zabalzalucas04-cell/Formula-Steering-Wheel-basen-on-Raspi-PI-PICO-W/README.md

# Formula-Steering-Wheel-basen-on-Raspi-PI-PICO-W
Procedimiento y descripcion paso a paso para crear un Aro estilo fórmula, impreso en 3D, con 4 levas digitales, 8 botones, 3 encoders rotativos, 2 swtiches de encoders y un encoder con funcion multinivel de 5 switches virtuales de seleccion de estado ciclico.

Su primera concepción se utiliza con la base PXN V10. Direct Drive Force Feedback.
WhatsApp Image 2026-11-07 at 8 04 27 PM
WhatsApp Image 2026-11-07 at 8 02 23 PM
Para ver todas las funcionalidades del aro, lée el documento "Documentación del Firmware SimRacing (Raspberry Pi Pico W)"
# Planes de mejoras a futuro:
**Mejoras de Grip:**
  * Implementación de un material elastómero para mejorar el grip y sujeción

**Cambio en el Hardware**
  * Utilización de placas controladoras con mayor compatibilidad de uso.
  * Implementación de display, dashboards, timers.

**Compatibilidad**
  * Creación de Quick Release genéricos para la compatibilidad con más bases.
  * Posibilidad de software para personalizar aro.
