zabalzalucas04-cell/Formula-Steering-Wheel-basen-on-Raspi-PI-PICO-W/Comercial Parts.md

# 📋 Lista de Componentes y Hardware del Proyecto

## ⚡ Componentes Electrónicos y Mecánicos
* **1×** Raspberry Pi Pico W
* **4×** Botones NA 12 mm
* **3×** Botones NA 7 mm
* **3×** Encoders KY-040
* Cable 0.5 mm
* **4×** Switches finales de carrera
* **8×** Imanes de neodimio (8 mm × 2 mm)

---

## 🛠️ Tornillería y Fijación
* **8×** Tornillos Phillips M3 × 16 mm *(Fijación de Grips derecho e izquierdo)*
* **9×** Tornillos rosca plástica M3 × 16 mm *(Fijación de adaptador de Quick Release y Cover)*
* **10×** Tornillos Phillips M3 × 10 mm
* **4×** Tornillos M5 × 50 mm + Tuercas correspondientes
