zabalzalucas04-cell/Formula-Steering-Wheel-basen-on-Raspi-PI-PICO-W/3D_parts/main_case_v1.stl

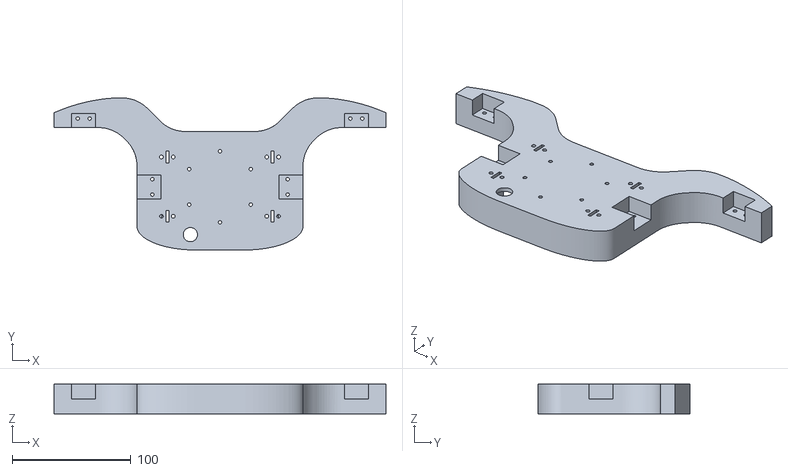
[picture p1: CAD file, 2026-11-08]
3D_parts/main_case_v1.stl
280.0 x 128.3 x 25.0
