zabalzalucas04-cell/Formula-Steering-Wheel-basen-on-Raspi-PI-PICO-W/3D_parts/Grip_R_bigstl.stl

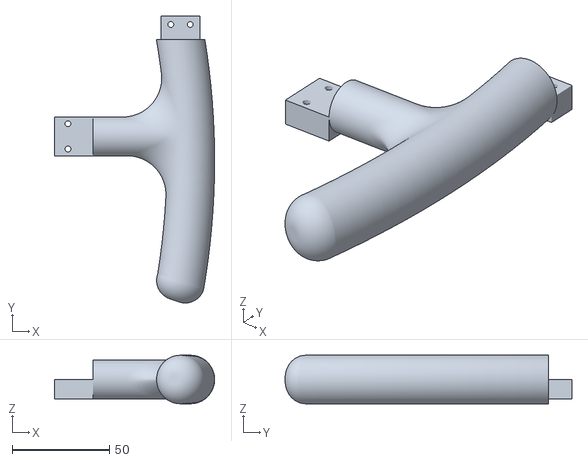
[picture p2: CAD file, 2026-11-08]
3D_parts/Grip_R_bigstl.stl
82.5 x 147.8 x 25.0
