zabalzalucas04-cell/Formula-Steering-Wheel-basen-on-Raspi-PI-PICO-W/3D_parts/Shifter_body.stl

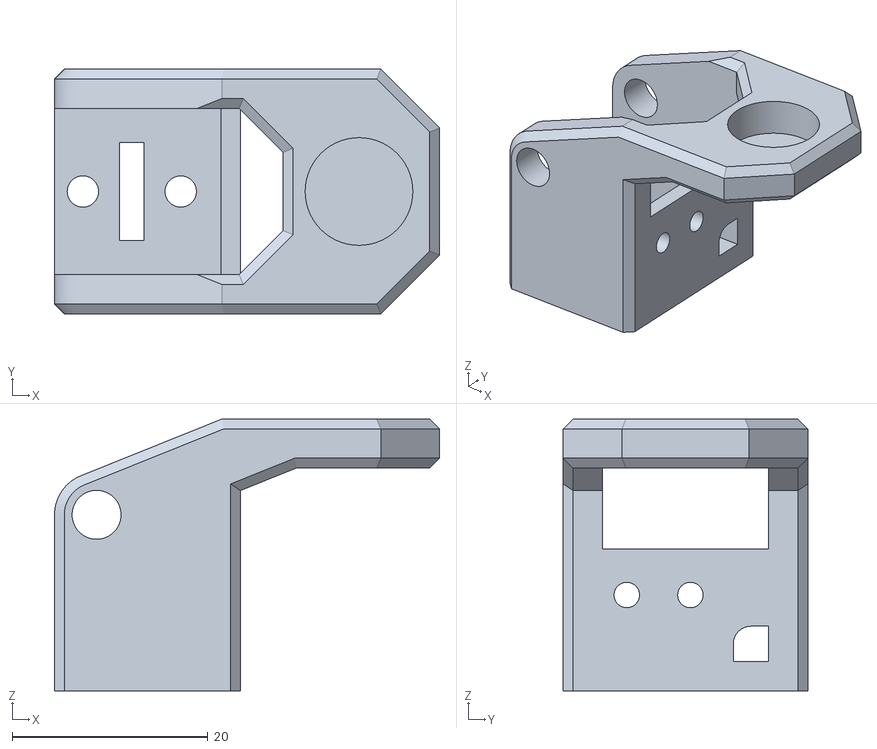
[picture p3: CAD file, 2026-11-08]
3D_parts/Shifter_body.stl
39.4 x 25.0 x 27.8
