zabalzalucas04-cell/Formula-Steering-Wheel-basen-on-Raspi-PI-PICO-W/3D_parts/70MM_PXN_V10_Adapter.3mf

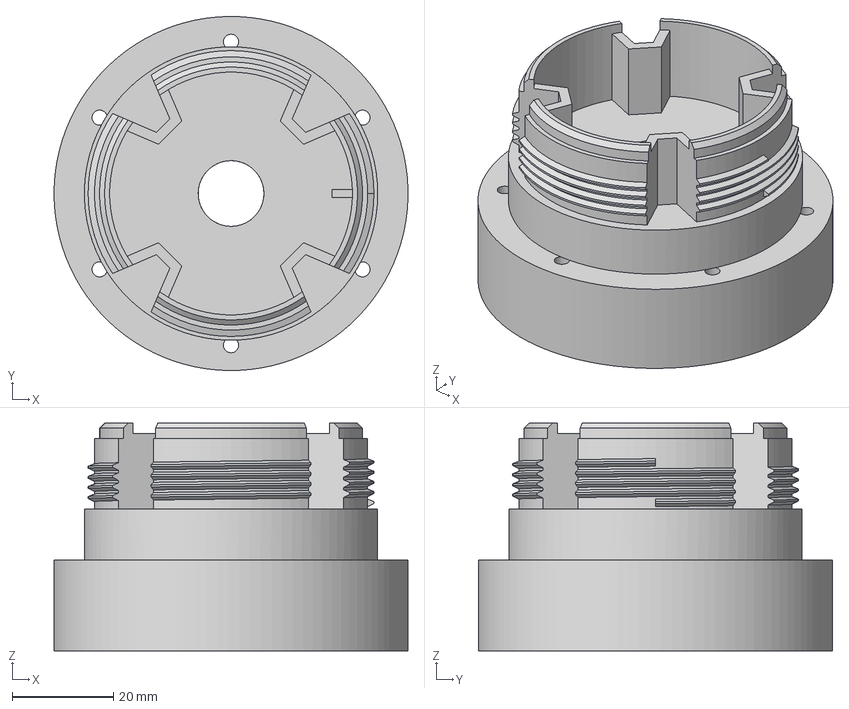
[picture p4: CAD file, 2026-11-07]
3D_parts/70MM_PXN_V10_Adapter.3mf
70.0 x 70.0 x 45.0 mm
