zabalzalucas04-cell/Formula-Steering-Wheel-basen-on-Raspi-PI-PICO-W/3D_parts/Cover_1.stl

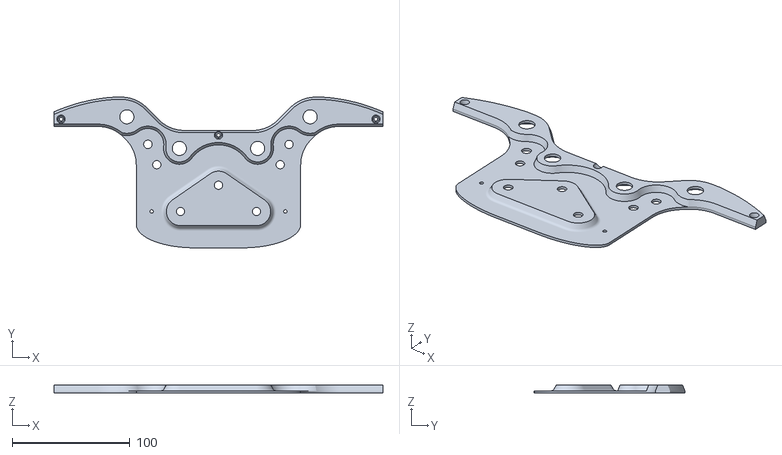
[picture p5: CAD file, 2026-11-07]
3D_parts/Cover_1.stl
280.0 x 128.3 x 7.00
