zabalzalucas04-cell/Formula-Steering-Wheel-basen-on-Raspi-PI-PICO-W/3D_parts/Shifter_lever.stl

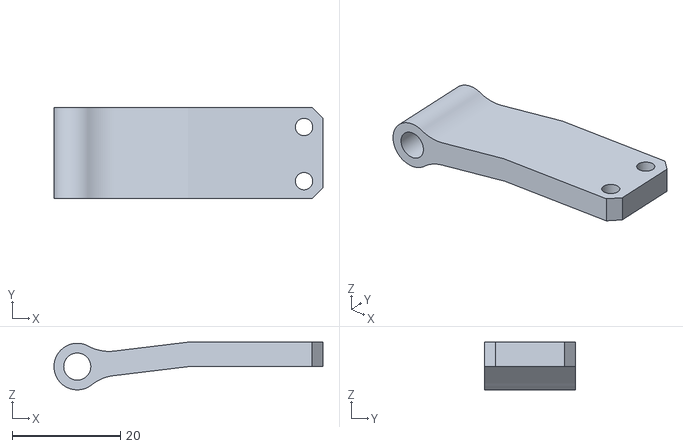
[picture p6: CAD file, 2026-11-07]
3D_parts/Shifter_lever.stl
49.7 x 16.8 x 8.81
