zabalzalucas04-cell/Formula-Steering-Wheel-basen-on-Raspi-PI-PICO-W/3D_parts/Part Studio 2 - grip_R.stl

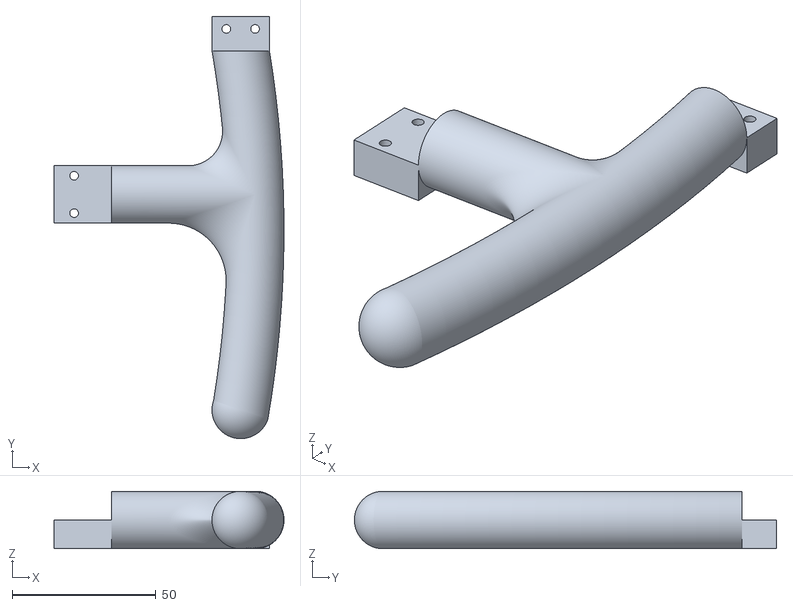
[picture p7: CAD file, 2026-11-07]
3D_parts/Part Studio 2 - grip_R.stl
80.1 x 147.0 x 20.0
