zabalzalucas04-cell/Formula-Steering-Wheel-basen-on-Raspi-PI-PICO-W/3D_parts/EC11 Encoder Knob D Shaft.stp

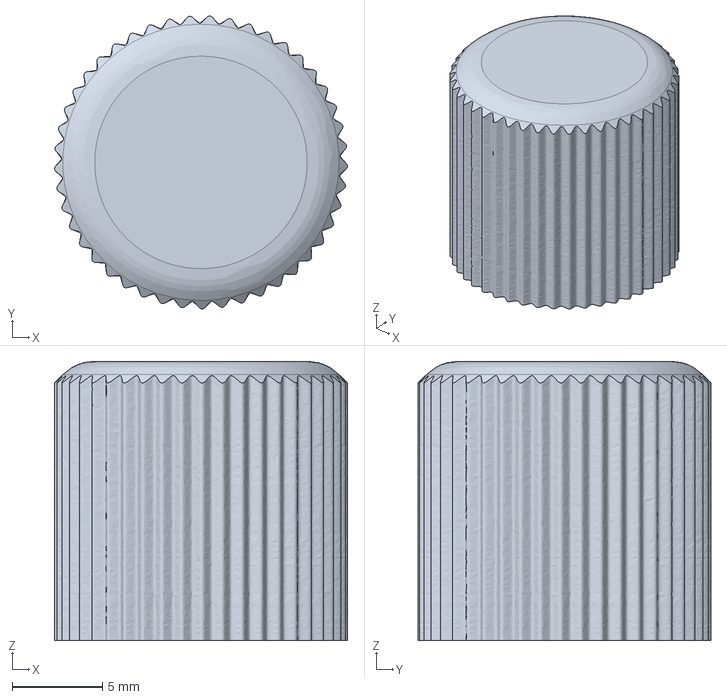
[picture p8: CAD file, 2026-11-07]
3D_parts/EC11 Encoder Knob D Shaft.stp
16.3 x 16.2 x 15.5 mm
