zabalzalucas04-cell/Formula-Steering-Wheel-basen-on-Raspi-PI-PICO-W/(commit log)

2026-11-07 Add files via upload
    Adding the 3D printed parts
    [70MM_PXN_V10_Adapter.3mf, Cover_1.stl, EC11 Encoder Knob D Shaft.stp, Part Studio 2 - grip_R.stl, Shifter_body.stl, Shifter_lever.stl]
2026-11-07 Add files via upload
    Adding the full version of the steering wheel firmware
